OwenBallCMU/98154_Project/src/I2C.sv

`default_nettype none


//Module to interface with I2C bus
module I2C
 (input  logic SCL_in, SDA_in, clock, reset,
  input  logic [7:0] parallel_in,
  input  logic [1:0] addr_sel,
  output logic SDA_out,
  output logic [7:0] reg_out,
  output logic [8*`REGCOUNT-1:0] registers_packed);

  logic SCL_sync, SDA_sync, counted_8, clear_counter, start, stop, clear_start;
  logic clear_stop, addr_valid, in_enable, send_ack, we, out_en, ACK;
  logic SCL_posedge, SCL_negedge, SDA_posedge, SDA_negedge; 
  logic [7:0] data_in;
  logic reg_sel_en, reg_sel_inc, data_out;
  logic [4:0] reg_sel_latched;
  logic [3:0] count;

  //Synchronize bus lines and detect edges
  synchronizer_edge_detect S1 (.async(SCL_in), .sync(SCL_sync), .clock, .sig_posedge(SCL_posedge), .sig_negedge(SCL_negedge));
  synchronizer_edge_detect S2 (.async(SDA_in), .sync(SDA_sync), .clock, .sig_posedge(SDA_posedge), .sig_negedge(SDA_negedge));

  //Generate the I2C output
  gen_output OUT (.send_ack, .serial_out(data_out), .out_en, .SDA_out);

  //Counts the number of bits that have been sent on the line
  count_8 COUNT (.clock, .en(SCL_posedge), .done(counted_8), .clear(clear_counter), .count);

  //Detect start and stop conditions
  start_detect START (.start, .clock, .SCL(SCL_sync), .SDA_negedge, .clear_start(clear_start | reset));
  stop_detect  STOP  (.stop,  .clock, .SCL(SCL_sync), .SDA_posedge, .clear_stop(clear_stop | reset));

  //Reads in the data from the bus
  data_input IN_REG (.clock, .SCL_posedge, .SDA(SDA_sync), .enable(in_enable), .data_in, .reset);

  //Checks if the address matches 0x20
  check_addr ADDR (.data_in(data_in[7:1]), .addr_valid, .addr_sel);

  //Selects the target register
  reg_sel REG(.reset, .clock, .SCL_negedge, .sel_out(reg_sel_latched), .sel_in(data_in[4:0]), .en(reg_sel_en), .inc(reg_sel_inc));

  //Interface with the memory
  memory MEM (.we, .clock, .SCL_negedge, .reset, .sel(reg_sel_latched), .count(count[2:0]), 
              .data_in(data_in[7:0]), .data_out, .reg_out, .registers_packed, .parallel_in);

  //Generate the acknowledge
  get_ack READ_ACK (.clock, .SCL_posedge, .SDA(SDA_sync), .ACK);

  //Instantiate the FSM
  FSM M (.*);

endmodule: I2C
