OwenBallCMU/98154_Project/(commit log)

2023-04-11 Adding workflow
    [pin_order.cfg]
2023-04-17 Back to 9 regs and PWM1
2023-04-17 Fixed for loop bounds
    [datapath.sv]
2023-05-03 UART tested
2023-05-03 Multi-address + fixed bug with r/w wrap around
    [I2C.sv, chip.sv, datapath.sv, picocode.py, top.sv]
2023-05-04 Adding data frames to readme
2023-05-05 PWM photo
